ReaY25/projetoeletemb/README.md

# Projeto de Eletrônica Embarcada - UnB 2/2019
  Repositório para afins de promover o desenvolvimento do projeto de Controle de Luminosidade da matéria de Eletrônica Embarcada ministrada pelo Professor Gilmar Beserra.

  Neste reositório, será apresentado a implementação do projeto do Controle de Luminosidade de uma lâmpada LED, trabalho final destinado a disciplina de Eletrônica Embarcada pela UnB. 
  
  O projeto consiste de um sistema o qual embarca o controle de luminosidade de uma lâmpada LED por meio de comandos e sensores sensíveis a luminosidade do ambiente, o qual será controlada por meio de valores de ambientes de referência definida tanto pelo aparelho quanto pelo usuário.
© 2019 GitHub, Inc.
