ReaY25/projetoeletemb/(commit log)

2019-10-07 Ponto de Controle
    Ponto de Controle 1 revisado
2019-11-11 Deu errado
    Como fazer leitura de varias portas analogicas?
2019-11-11 Deu certo
    Leitura de apenas um sensor
